ve7mjc/auto-controller/README.md

# auto-controller
Embedded Automation Controller for Automobiles.  Provides a number of powerful and flexible aftermarket functionality.
