ve7mjc/auto-controller/hw/pcb/controller.brd

## EAGLE design hw/pcb/controller.brd (2016-01-28)

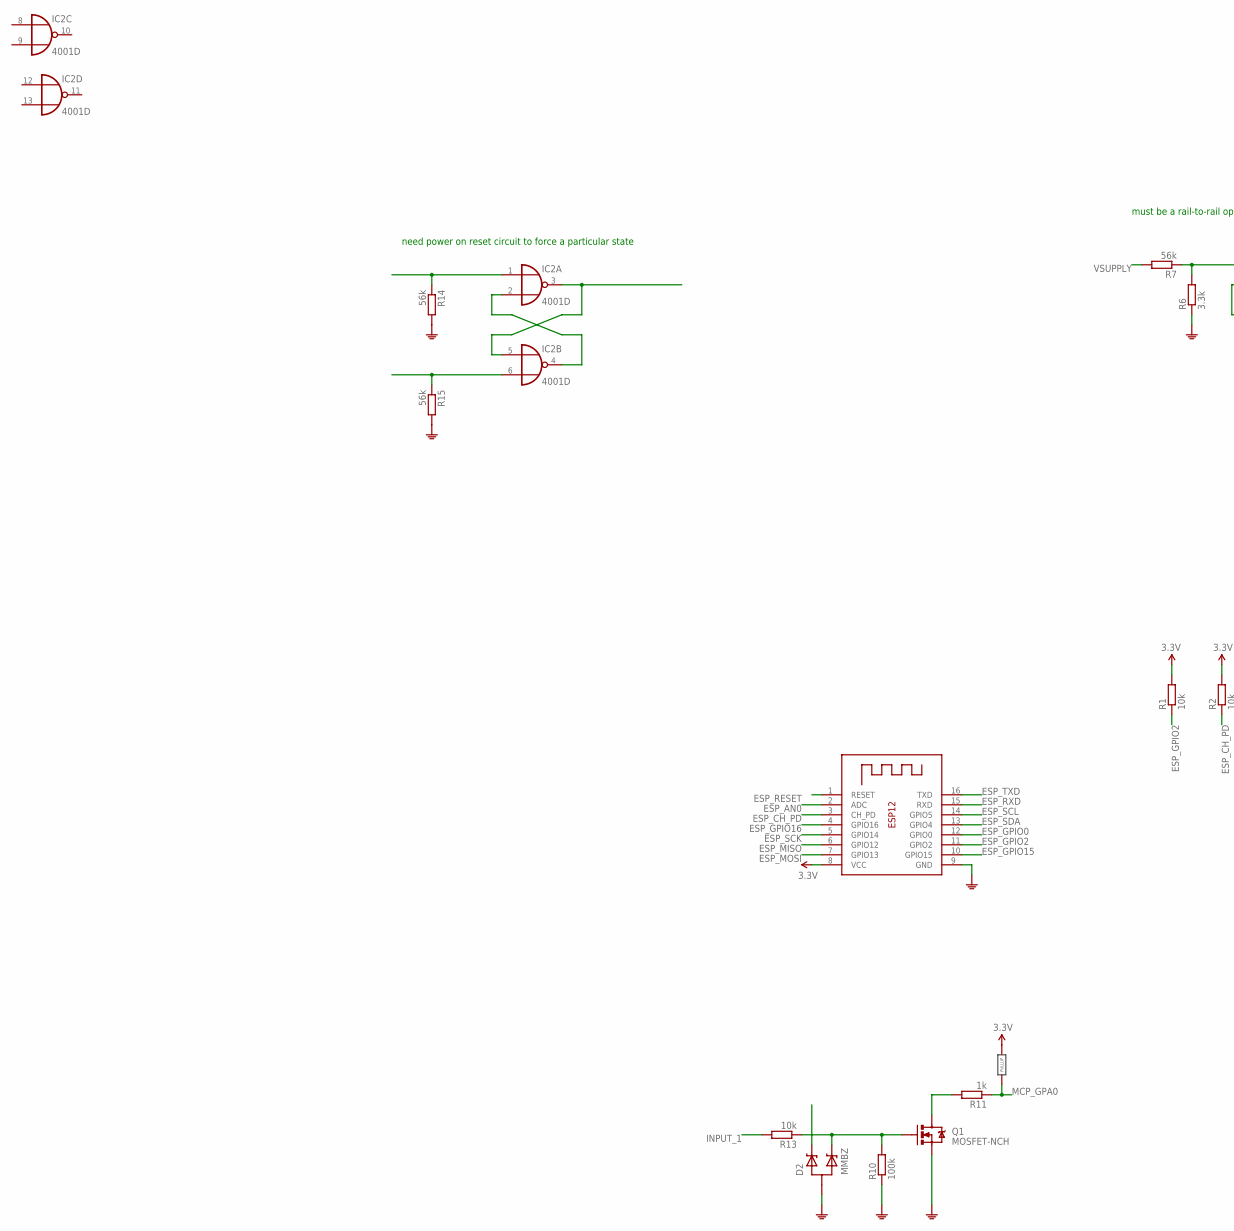
[picture p10: schematic controller.sch, sheet 1, ESP, part in row 1, column 1]

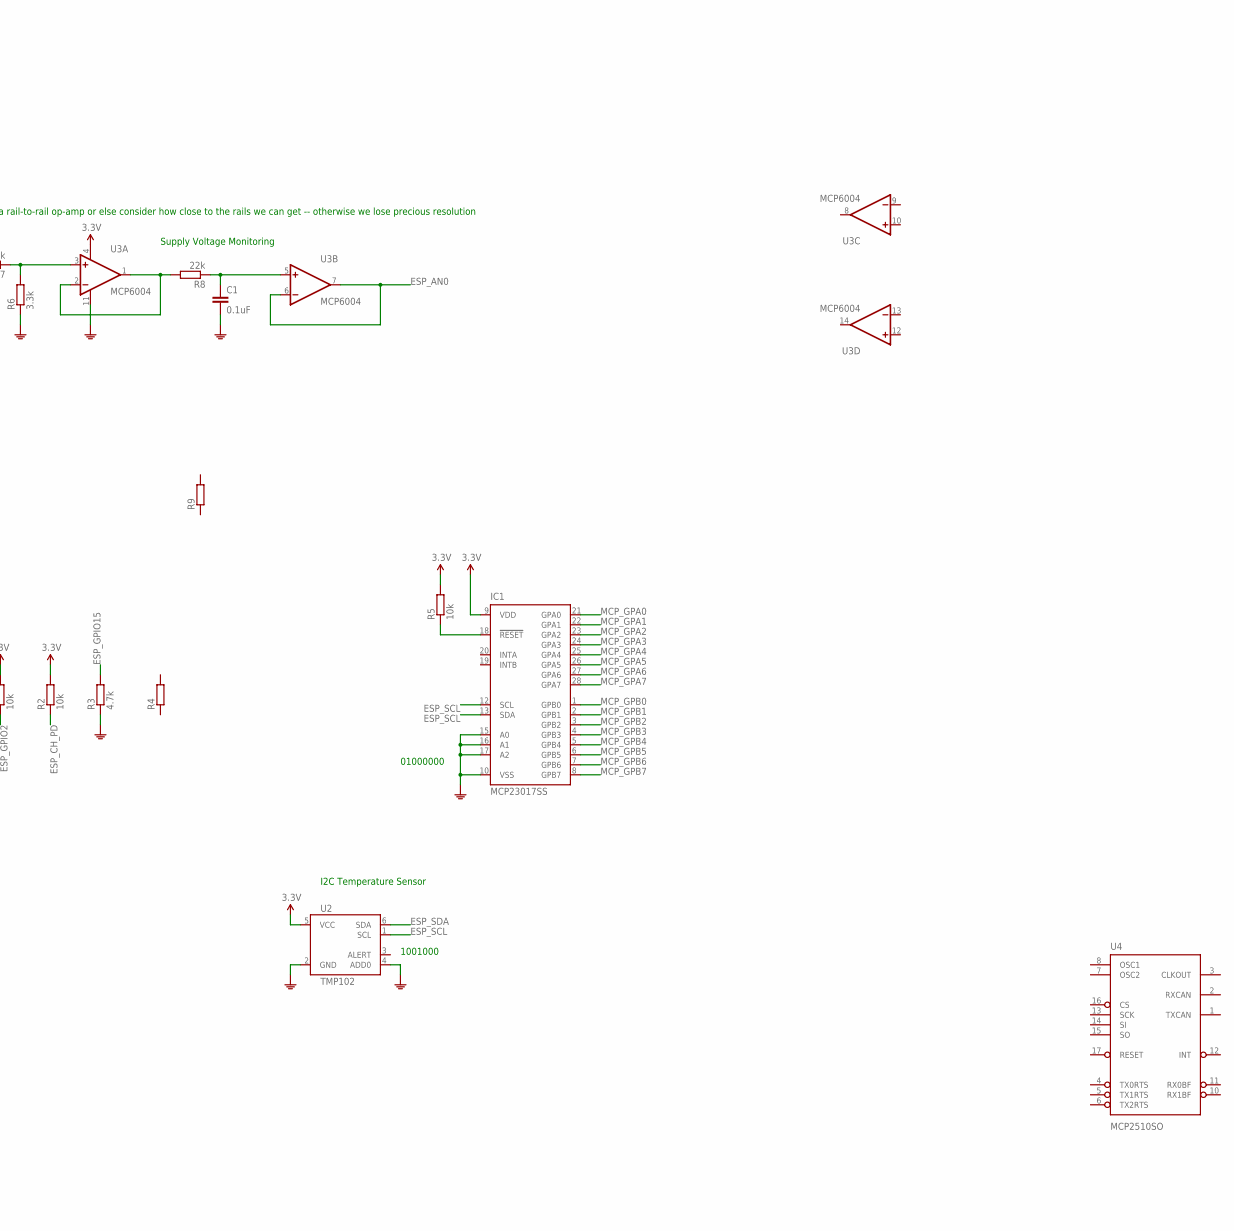
[picture p11: schematic controller.sch, sheet 1, ESP, part in row 1, column 2]

Parts:
C1: 0.1uF; C0603K
D2: MMBZ; SOT23
IC1: MCP23017SS; SSOP28
IC2: 4001D; SO14
Q1: MOSFET-NCH; SOT23-3
R1, R2, R5, R13: 10k; R0603
R3: 4.7k; R0603
R4, R9: R-EU_R0603; R0603
R6: 3.3k; R0603
R7, R14, R15: 56k; R0603
R8: 22k; R0603
R10: 100k; R0603
R11: 1k; R0603
U2: TMP102; SOT563
U3: MCP6004; TSSOP_14
U4: MCP2510SO; SO-18W
X1: ESP-12

Connections:
3.3V: IC1.9 (VDD), R1.2, R2.2, R5.2, U2.5 (VCC), U3.4 (V+), X1.8 (VCC)
ESP_AN0: U3.6 (-IN), U3.7 (OUT), X1.2 (ADC)
ESP_CH_PD: R2.1, X1.3 (CH_PD)
ESP_GPIO0: X1.12 (GPIO0)
ESP_GPIO2: R1.1, X1.11 (GPIO2)
ESP_GPIO15: R3.2, X1.10 (GPIO15)
ESP_GPIO16: X1.4 (GPIO16)
ESP_MISO: X1.6 (GPIO12)
ESP_MOSI: X1.7 (GPIO13)
ESP_RESET: X1.1 (RESET)
ESP_RXD: X1.15 (RXD)
ESP_SCK: X1.5 (GPIO14)
ESP_SCL: IC1.12 (SCL), IC1.13 (SDA), U2.1 (SCL), X1.14 (GPIO5)
ESP_SDA: U2.6 (SDA), X1.13 (GPIO4)
ESP_TXD: X1.16 (TXD)
GND: C1.2, D2.3 (ANODE), IC1.10 (VSS), IC1.15 (A0), IC1.16 (A1), IC1.17 (A2), Q1.2 (S), R3.1, R6.1, R10.1, R14.2, R15.2, U2.2 (GND), U2.4 (ADD0), U3.11 (V-), X1.9 (GND); also elsewhere on the board
INPUT_1: R13.2; also elsewhere on the board
INPUT_ACCESSORY: D2.2 (CATHODE_2), Q1.1 (G), R10.2, R13.1; also elsewhere on the board
MCP_GPA0: IC1.21 (GPA0), R11.1
MCP_GPA1: IC1.22 (GPA1)
MCP_GPA2: IC1.23 (GPA2)
MCP_GPA3: IC1.24 (GPA3)
MCP_GPA4: IC1.25 (GPA4)
MCP_GPA5: IC1.26 (GPA5)
MCP_GPA6: IC1.27 (GPA6)
MCP_GPA7: IC1.28 (GPA7)
MCP_GPB0: IC1.1 (GPB0)
MCP_GPB1: IC1.2 (GPB1)
MCP_GPB2: IC1.3 (GPB2)
MCP_GPB3: IC1.4 (GPB3)
MCP_GPB4: IC1.5 (GPB4)
MCP_GPB5: IC1.6 (GPB5)
MCP_GPB6: IC1.7 (GPB6)
MCP_GPB7: IC1.8 (GPB7)
unnamed: IC1.18 (!RESET), R5.1
unnamed: R6.2, R7.1, U3.3 (+IN)
unnamed: R8.2, U3.1 (OUT), U3.2 (-IN)
unnamed: C1.1, R8.1, U3.5 (+IN)
unnamed: Q1.3 (D), R11.2
unnamed: IC2.3 (O), IC2.5 (I0)
unnamed: IC2.1 (I0), R14.1
unnamed: IC2.6 (I1), R15.1
unnamed: IC2.2 (I1), IC2.4 (O)
VDD: IC2.14 (VDD), U4.18 (VDD)
VSS: IC2.7 (VSS), U4.9 (VSS)
VSUPPLY: R7.2; also elsewhere on the board

Notes on the sheet:
1001000
I2C Temperature Sensor
01000000
Supply Voltage Monitoring
must be a rail-to-rail op-amp or else consider how close to the rails we can get -- otherwise we lose precious resolution
need power on reset circuit to force a particular state

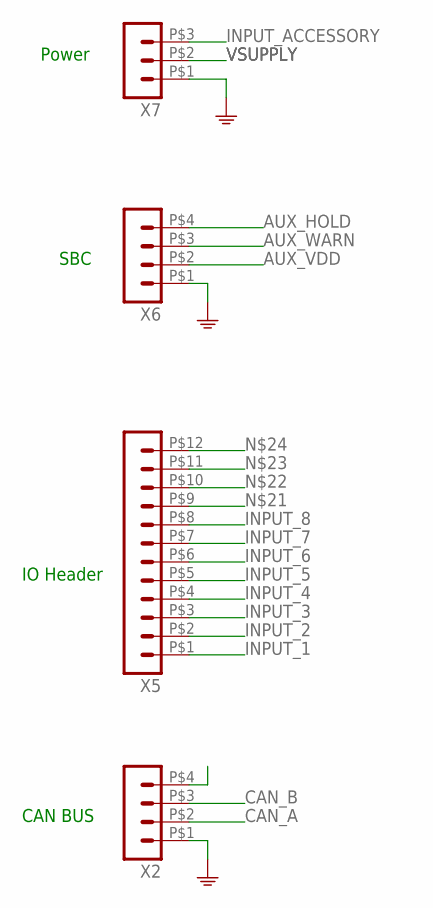
[picture p12: schematic controller.sch, sheet 2, Connectors]

Parts:
X2, X6: HEADER_POS4_43045-0401; 43045-0400
X5: HEADER_POS12_43045-1200; 43045-1200
X7: HEADER_POS3_43650-0300; 43650-0300

Connections:
AUX_HOLD: X6.P$4 (4)
AUX_VDD: X6.P$2 (2)
AUX_WARN: X6.P$3 (3)
CAN_A: X2.P$2 (2)
CAN_B: X2.P$3 (3)
GND: X2.P$1 (1), X6.P$1 (1), X7.P$1 (1); also elsewhere on the board
INPUT_1: X5.P$1 (1); also elsewhere on the board
INPUT_2: X5.P$2 (2)
INPUT_3: X5.P$3 (3)
INPUT_4: X5.P$4 (4)
INPUT_5: X5.P$5 (5)
INPUT_6: X5.P$6 (6)
INPUT_7: X5.P$7 (7)
INPUT_8: X5.P$8 (8)
INPUT_ACCESSORY: X7.P$3 (3); also elsewhere on the board
VSUPPLY: X7.P$2 (2); also elsewhere on the board

Notes on the sheet:
Power
SBC
IO Header
CAN BUS

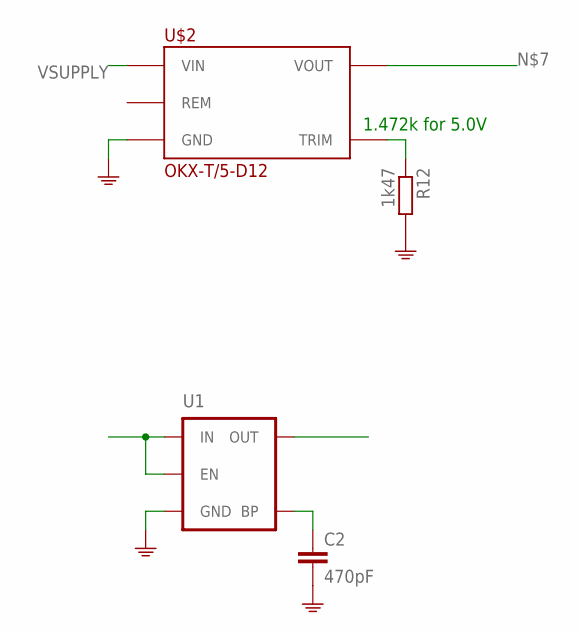
[picture p13: schematic controller.sch, sheet 3, Power]

Parts:
C2: 470pF; R0603
R12: 1k47; R0603
U1: MIC52053.3V; SOT23-5
U$2: OKX-T/5-D12; OKX_SIP

Connections:
GND: C2.2, R12.2, U1.2 (GND), U$2.P$3 (GND); also elsewhere on the board
unnamed: R12.1, U$2.P$2 (TRIM)
unnamed: U1.1 (IN), U1.3 (EN)
unnamed: C2.1, U1.4 (BP)
VSUPPLY: U$2.P$4 (VIN); also elsewhere on the board

Notes on the sheet:
1.472k for 5.0V

Board: 2 copper layers, 31 parts (0 on the bottom side), 26 nets, no tracks yet.
